OldSurferDude/UniversalLightSwitch/img/Bend resistor.jpg

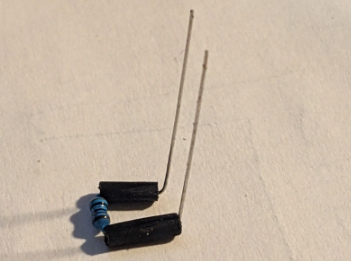
img/Bend resistor.jpg
