OldSurferDude/UniversalLightSwitch/img/Wrap 12F to TFT initial.jpg

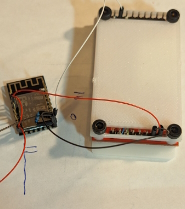
img/Wrap 12F to TFT initial.jpg
