OldSurferDude/UniversalLightSwitch/img/Wrap 12F to TFT.jpg

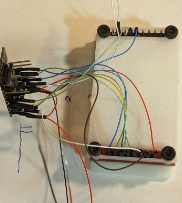
img/Wrap 12F to TFT.jpg
