OldSurferDude/UniversalLightSwitch/(commit log)

2023-11-13 Update and rename Universal Light Switch--PuttingItAllTogether.md to Putting It All Together.md
2023-11-13 Update and rename Universal Light Switch--hardware.md to Hardware.md
